rmckay1/SmartKoozie/README.md

# SmartKoozie
Files for COSC480 Smart Koozie
