rmckay1/SmartKoozie/docs/SmartKooziePosterFixed.pptx

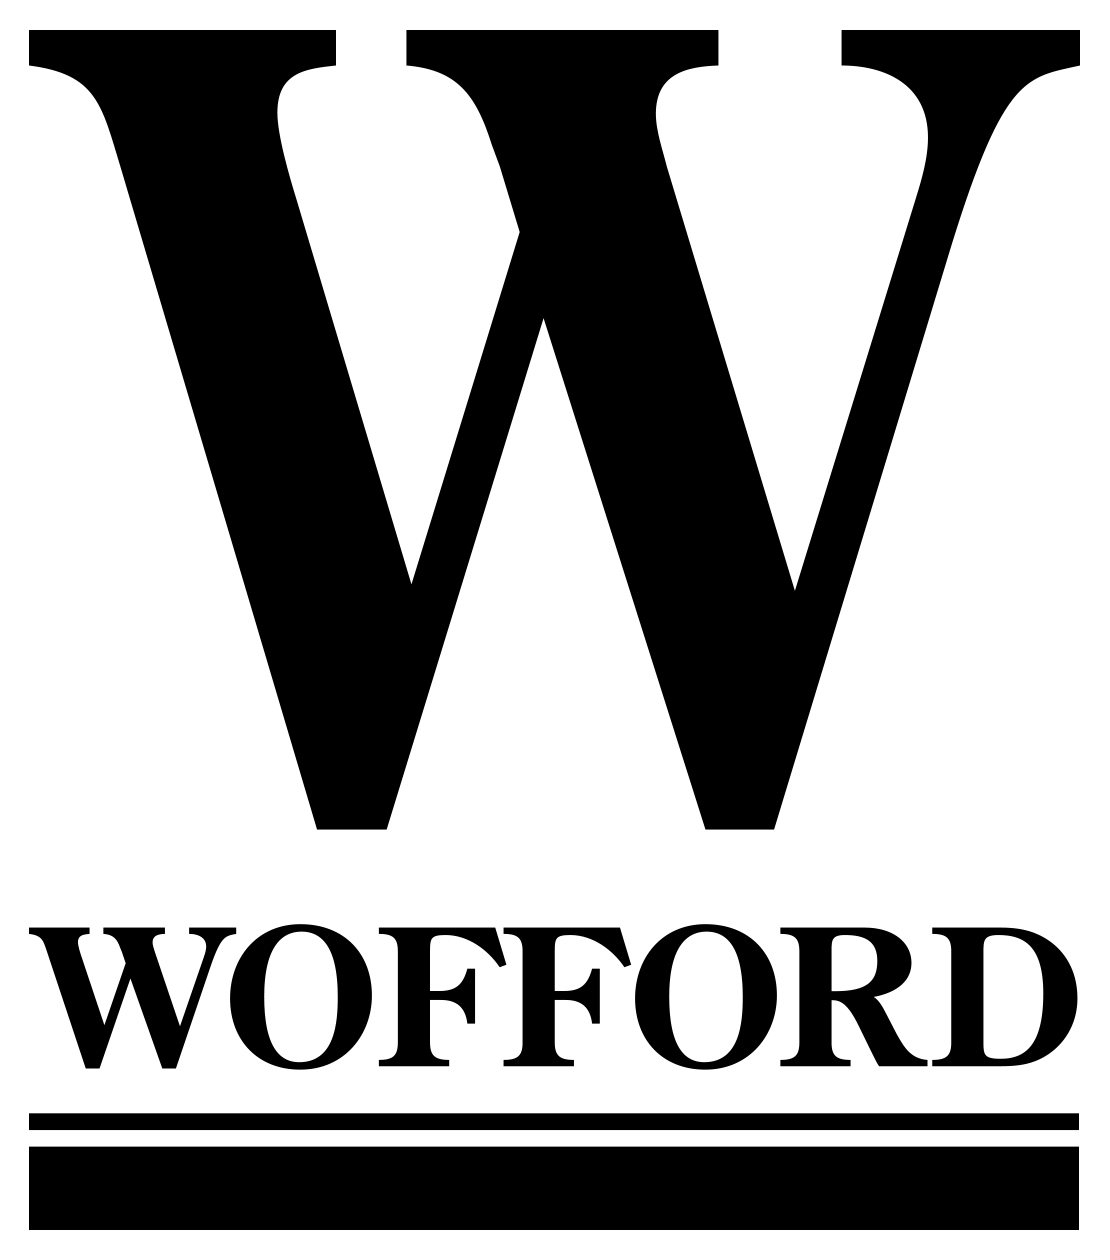
[picture p1: figure]

Smart Koozie
Robert McKay, Juan Salas, Yohan Ksor
Wofford College, South Carolina

To regulate beverage temperatures to maintain a consistently cool temperature to ensure optimal refreshment, regardless of external conditions.

Goal:

Problem:

Beverages rapidly lose their chill due:
    - Heat transfer from the surrounding air
    - Sunlight Exposure
    - The holder’s hand

Phone App Interface

Existing Solutions

- Koozies (limited insulation)
- Tumblers and Bottles (too bulky)
- Ice Cubes (dilutes drink)
- Refrigerator (not portable)
- Mini Fridges (not portable)

Our Approach

- Active cooling mechanism to maintain the beverage's cool temperature.
- App integration to turn on or off the cooling feature
- Portable design to have ease of cooling on the go.

System Flow

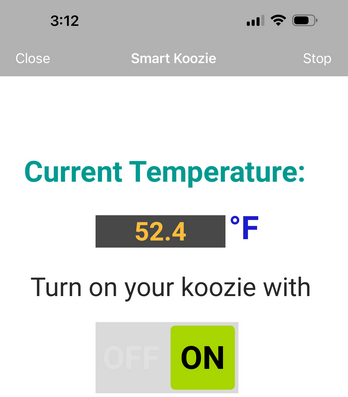
[picture p2: figure]

Prototype Anatomy

System Overview

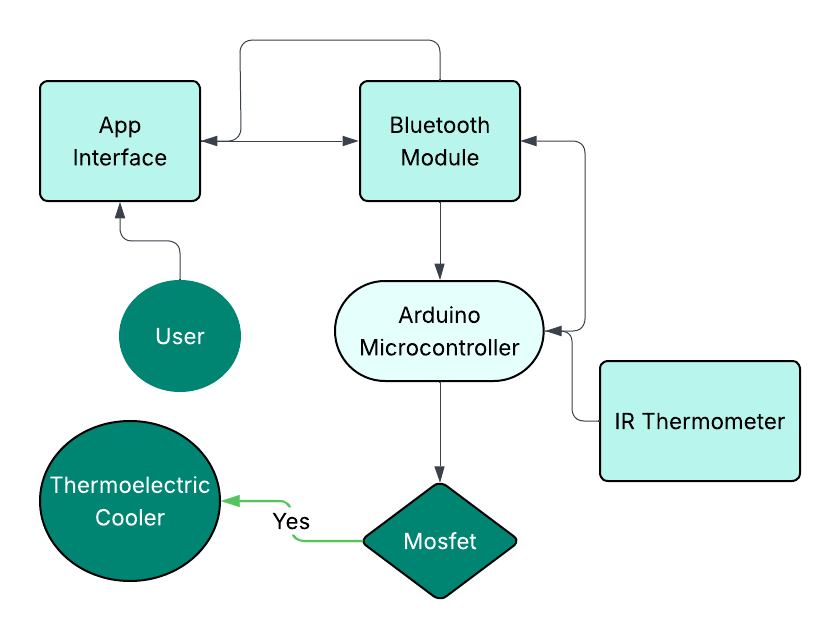
[picture p3: figure]

Prototype

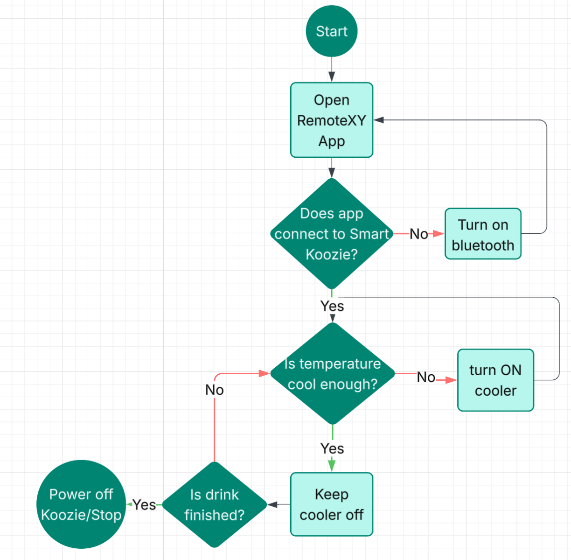
[picture p4: figure]
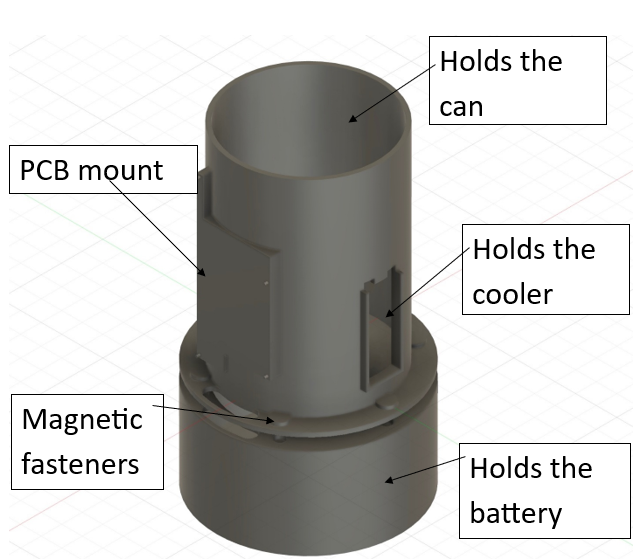
[picture p5: figure]

Challenges

- Power step-down
- Cooling management
- Heat dissipation for micro components
- App integration

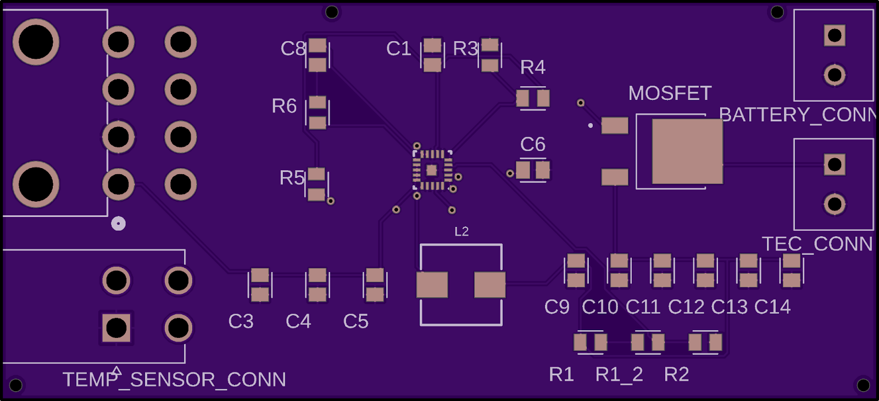
[picture p6: figure]

Future Work

- Adding adjustable temperature ability
- Modifying/Creating an app User Interface
- Improving product design
