rmckay1/SmartKoozie/hardware/original-390F0387-4EFE-4FF3-896C-EB0C90B5BBE3.jpeg

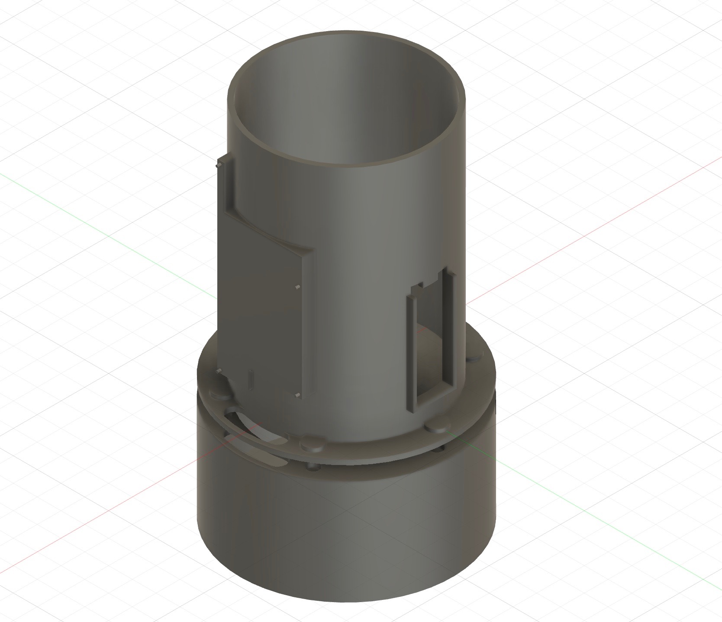
hardware/original-390F0387-4EFE-4FF3-896C-EB0C90B5BBE3.jpeg
