rmckay1/SmartKoozie/hardware/Schematic/First_ROUGHT_Draft.png

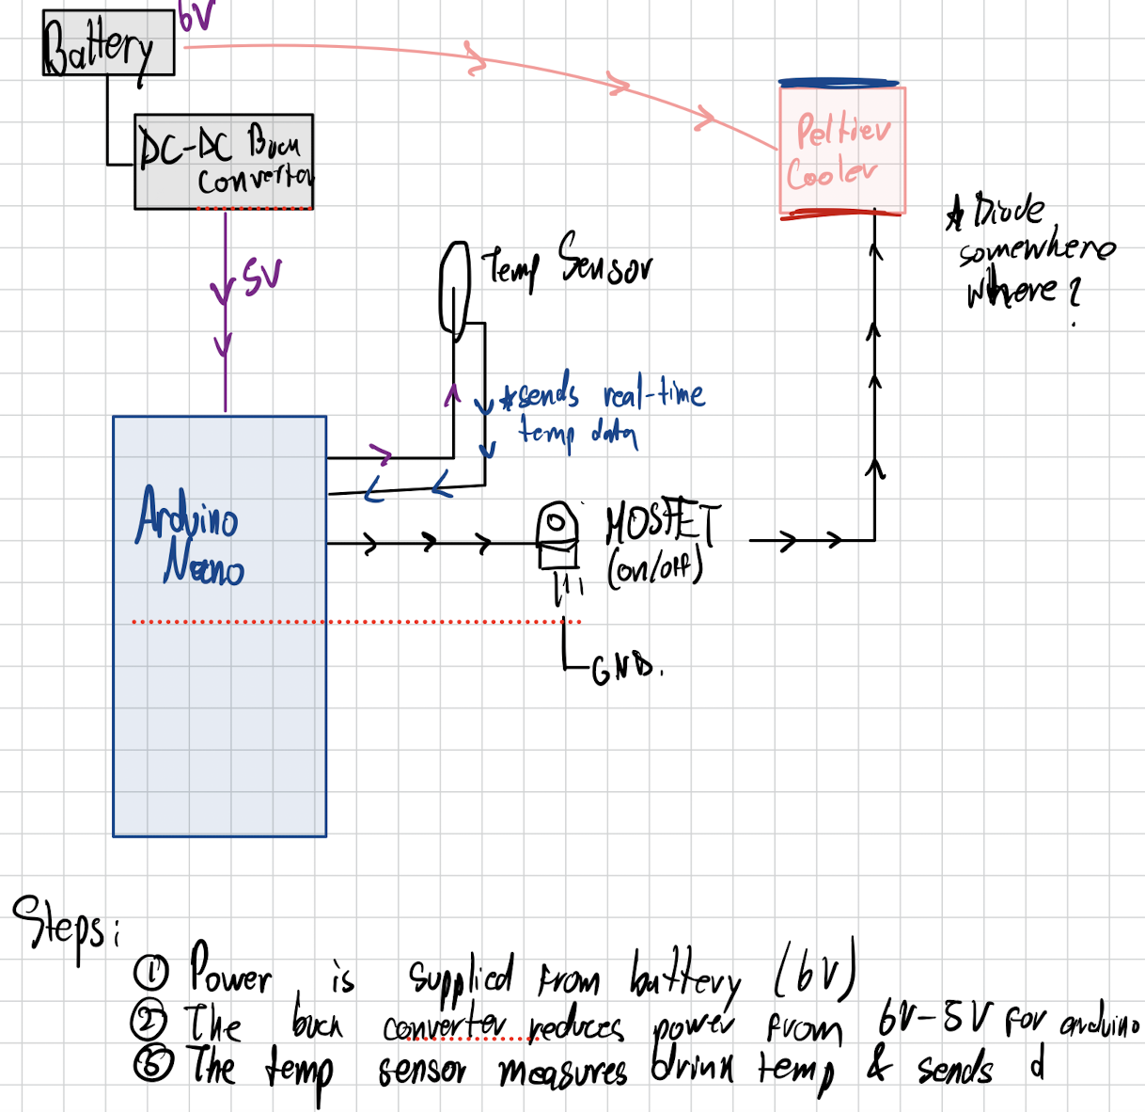
hardware/Schematic/First_ROUGHT_Draft.png
