rmckay1/SmartKoozie/hardware/Schematic/Second_ROUGH_Draft.png

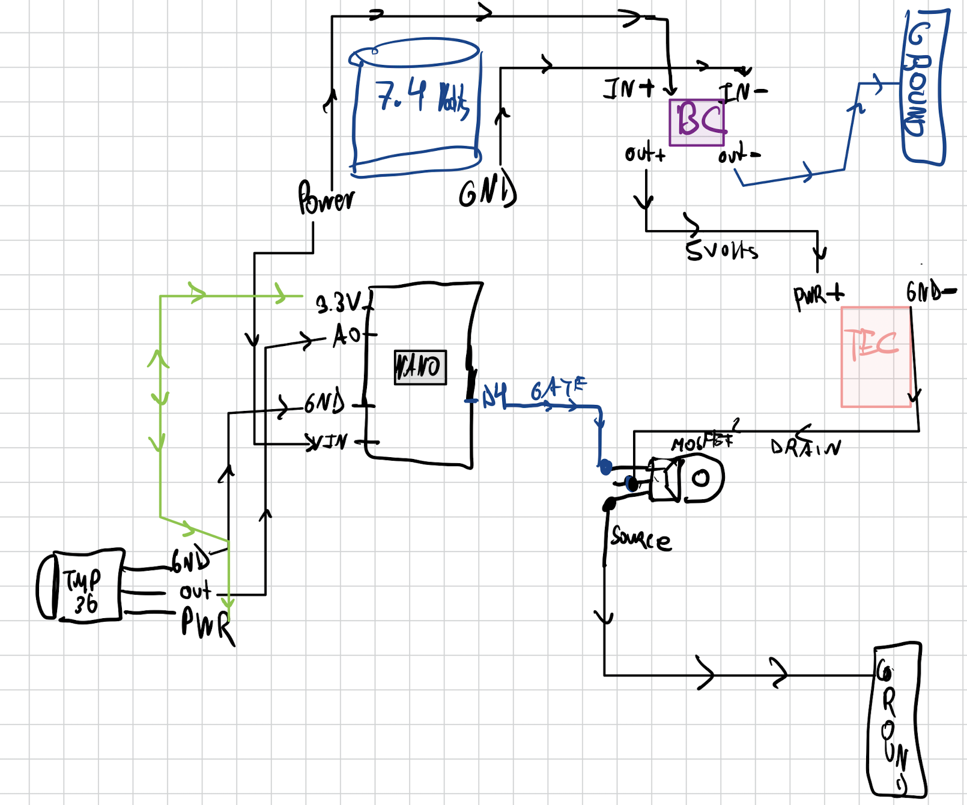
hardware/Schematic/Second_ROUGH_Draft.png
