rmckay1/SmartKoozie/receipts/Purchases_Totals.xlsx

Sheet: Juan's purchases
Component | Part # | Purpose | Buyer | Price
Arduino Nano ESP32 | 1050-ABX00083-ND | Microcontroller | Juan | $35.46
TMP36 Temp Sensors | 505-TMP36GT9Z-ND | Measure temp | Juan | $10.66
USB-C to USB adapter | N/A | Upload data from arduino to laptop | Juan | $10.69
DC-DC Buck Conv | LM2596 | Step down voltage | Juan | $22.97
Heatsinks | N/A | disspate heat | Juan
Thermal Paste | N/A | disspate heat | Juan
Indoor Thermometer | N/A | Adjust temp sensor to right temp | Juan | $4.27
Thermal Glue | N/A | glue heatsink and mosfet | Juan | $7.48
Total |  |  |  | $91.53

Sheet: Robert's purchases
Component | Part # | Purpose | Buyer | Price
Digikey 1 |  |  |  | $74.53
Digikey 2 |  |  |  | $23.82
OSHpark |  |  |  | $21.25
Capacitors |  |  |  | $15.94
Magnets |  |  |  | $6.41
IR Sensor |  |  |  | $12.71
Battery Charger |  |  |  | $7.48
Battery |  |  |  | $20.52
Total |  |  |  | $182.66

Sheet: Yohan's purchases
Component | Part # | Purpose | Buyer | Price
Peltier Cooler | TEC1-12706 | Cooling | Yohan | $10.48
Total |  |  |  | $10.48

Sheet: Totals
Juan | $91.53 | Owed to Robert
Robert | $182.66 | Juan | Yohan
Yohan | $10.48 | $3.36 | $84.41
Total | $284.67
Even per person | $94.89
