rmckay1/SmartKoozie/receipts/OrderedParts.png

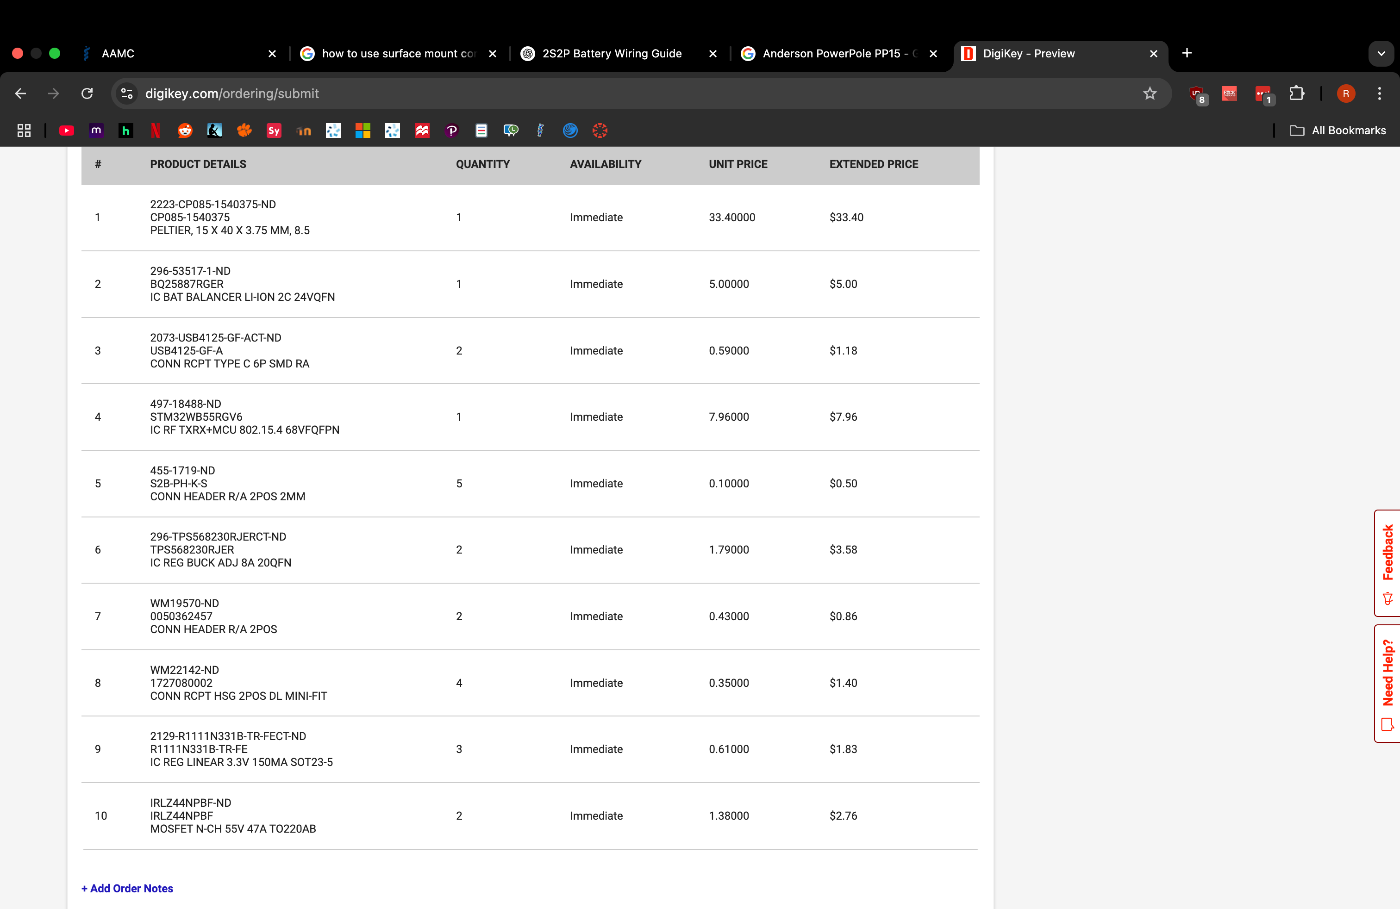
receipts/OrderedParts.png
