rmckay1/SmartKoozie/(list of files, cad)

Other CAD files:
hardware/BatteryPack v8.f3d
hardware/CoozieInnerShell v17.f3d
