rmckay1/SmartKoozie/hardware/PCB_v5.brd

## EAGLE design hardware/PCB_v5.brd (2025-04-17)

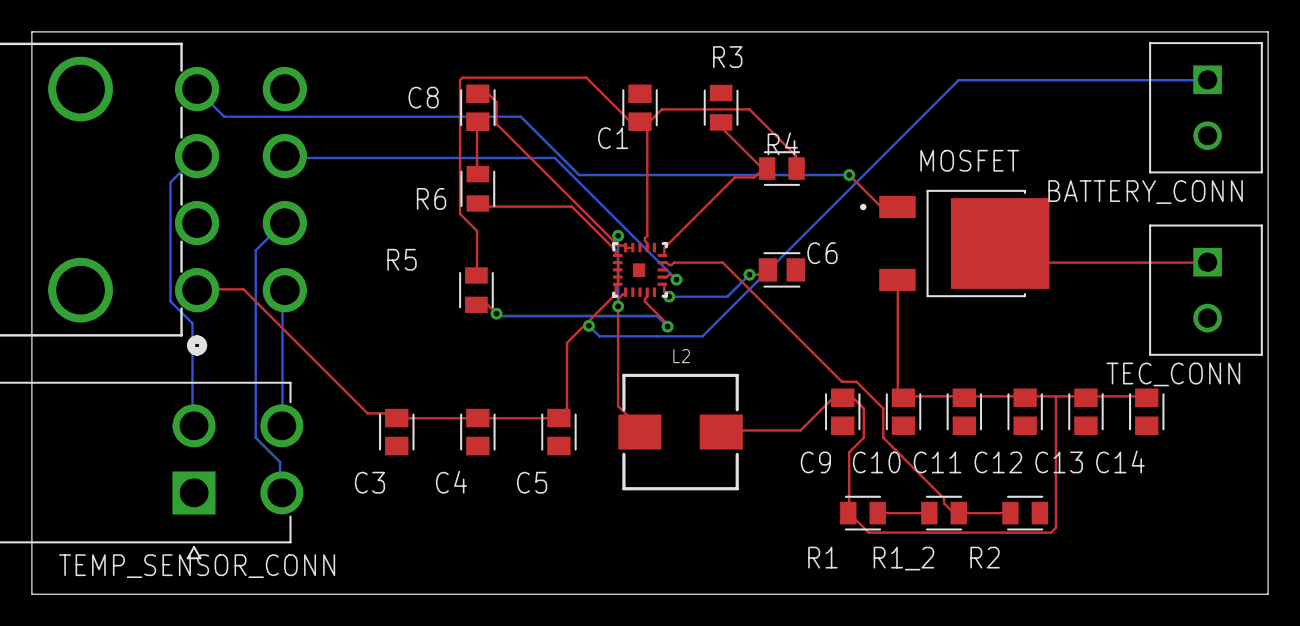
[picture p11: board PCB_v5.brd from above]

Board: 2 copper layers, 77.4 x 35.2 mm, 26 parts (0 on the bottom side), 18 nets.

Parts:
ARDUINO_CONN: 39301080CONN_5569-08A_MOL; CONN_5569-08A_MOL
BATTERY_CONN: OSTTE020104; OST_OSTTE020104
BUCK_CONVERTER: TPS568230RJERRJE0020A; RJE0020A
C1: 1µF; CAPC2012X110
C3, C4, C10, C11, C12, C13, C14: 22µF; CAPC2012X110
C5, C8, C9: 0.1µF; CAPC2012X110
C6: 22nF; CAPC2012X110
L2: 1.5uF; WE-HCI_7050
MOSFET: TSM340N06CP_ROG; TRANS_TSM340N06CP_ROG
R1: 280k; RESC2012X65
R1_2: 10k; RESC2012X65
R2: 30k; RESC2012X65
R3: 5.1k; RESC2012X65
R4: 330k; RESC2012X65
R5: 100K; RESC2012X65
R6: 0; RESC2012X65
TEC_CONN: OSTTE020104; OST_OSTTE020104
TEMP_SENSOR_CONN: 353180420; MOLEX_353180420

Connections:
5V: ARDUINO_CONN.3, TEMP_SENSOR_CONN.2
COOLER_PWR: MOSFET.2, TEC_CONN.1
EN: ARDUINO_CONN.7, BUCK_CONVERTER.12
GND: ARDUINO_CONN.2, BATTERY_CONN.2, BUCK_CONVERTER.7, BUCK_CONVERTER.8, BUCK_CONVERTER.10, BUCK_CONVERTER.13, BUCK_CONVERTER.16, BUCK_CONVERTER.18, BUCK_CONVERTER.21, C1.2, C3.1, C4.1, C5.1, C6.2, C9.1, C10.1, C11.1, C12.1, C13.1, C14.1, R2.2, R3.1, TEC_CONN.2, TEMP_SENSOR_CONN.1
MODE: BUCK_CONVERTER.15, R3.2, R4.2
unnamed: BUCK_CONVERTER.9, R5.2
unnamed: BUCK_CONVERTER.11, C6.1
unnamed: BUCK_CONVERTER.1, R6.1
unnamed: C8.2, R6.2
unnamed: BUCK_CONVERTER.14, R1_2.2, R2.1
unnamed: R1.2, R1_2.1
PWM: ARDUINO_CONN.4, MOSFET.1
SCL: ARDUINO_CONN.5, TEMP_SENSOR_CONN.4
SDA: ARDUINO_CONN.6, TEMP_SENSOR_CONN.3
SW: BUCK_CONVERTER.6, BUCK_CONVERTER.19, BUCK_CONVERTER.20, C8.1, L2.1
VCC: BUCK_CONVERTER.17, C1.1, R4.1, R5.1
VIN: ARDUINO_CONN.1, BATTERY_CONN.1, BUCK_CONVERTER.2, BUCK_CONVERTER.3, BUCK_CONVERTER.4, BUCK_CONVERTER.5, C3.2, C4.2, C5.2
VOUT: C9.2, C10.2, C11.2, C12.2, C13.2, C14.2, L2.2, MOSFET.3, R1.1
