rmckay1/SmartKoozie/docs/test/can_temperature_data.xlsx

Time | Outside Temp (°F) | Can Temp (No Insulation °F) | Can Temp (With Insulation °F)
12:12 PM | 73 | 50 | 48.9
12:24 PM | 74 | 55.4 | 50.7
12:35 PM | 75 | 61 | 52.7
12:47 PM | 75 | 66 | 55.2
1:01 PM | 75 | 71.6 | 58.6
1:12 PM | 76 | 73.2 | 60.6
