rmckay1/SmartKoozie/docs/test/can_temperature_chart.png

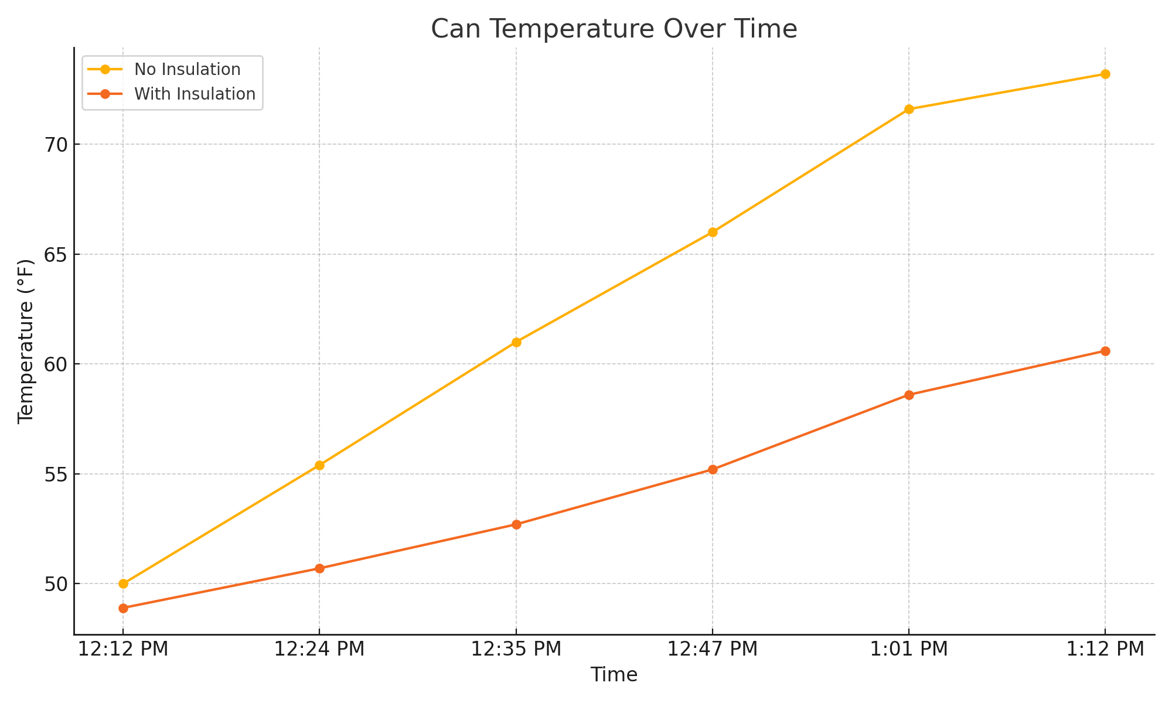
docs/test/can_temperature_chart.png
