rmckay1/SmartKoozie/(commit log)

2025-04-02 Starting file of our schematic, created the pins for the Nano
    [Schematic.sch]
2025-04-03 created symbol for the mosfet and added it to the schematic
    [Schematic.sch]
2025-04-03 added the open pins in the schematic for the buck converter
    [Schematic.sch]
2025-04-09 Added a code to test MOSFET with external LED
2025-04-09 Uploaded the final code for Smart Koozie which connects to the Arduino through bluetooth and the user is able to turn on/off cooler from app.
2025-04-10 Updated receipt folder with new receipts
    [Purchases_Totals.xlsx]
2025-04-10 Updates some things on the RemoteXY, made it so switch is off by default
2025-04-15 Add files via upload
    Code for IR temperature sensor
2025-04-18 Tried calibratring tmp36 temperature, unsucessful attempt
2025-04-18 Upload some useful drafts useful to build schematic
2025-04-22 Sucessfully calibrated tmp36 temp sensor
2025-04-24 Implemented LEDs to demo
2025-04-29 purchased another cooler that is bigger and cheaper
    [Purchases_Totals.xlsx]
2025-05-06 bought a 40mm x 40mm x 20mm heat sink and added to excel sheet
    [Purchases_Totals.xlsx]
2025-05-13 Ran a test for checking a can with insulation and without to show the value of insulation around the can
    [can_temperature_data.xlsx]
2025-05-14 Update purchase totals excel
    [Purchases_Totals.xlsx]
2025-05-14 Upload purchase totals
    [Purchases_Totals.xlsx]
