rmckay1/SmartKoozie/(notices)

Notices in the files:
docs/README.md:
License: MIT
parts and their libraries:
COPYRIGHT: Copyright (C) 2025 Ultra Librarian. All rights reserved.
SparkFun-Connectors: Licensing: Creative Commons ShareAlike 4.0 International - https://creativecommons.org/licenses/by-sa/4.0
